BadgePiratesLLC/CactusCon_11/Images/20221024_151729.jpg

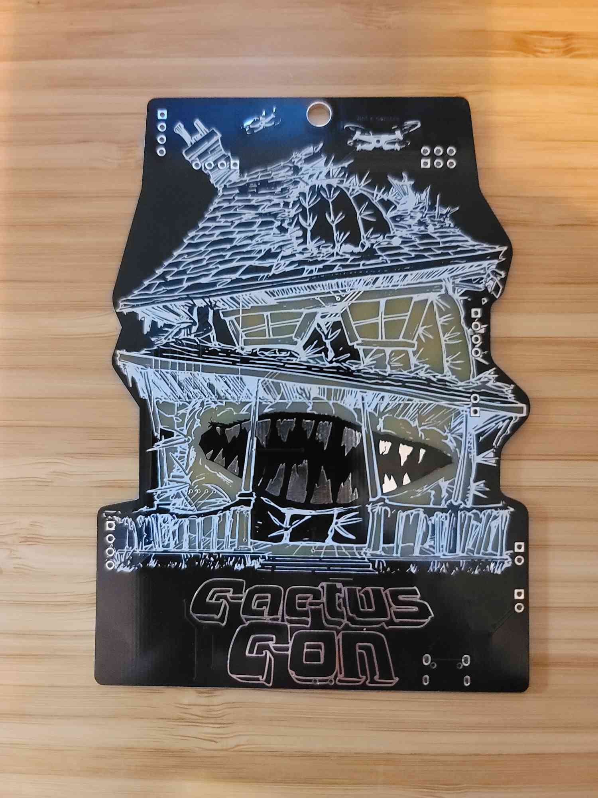
Images/20221024_151729.jpg
