BadgePiratesLLC/CactusCon_11/Images/Project-Saguaro_ Front.png

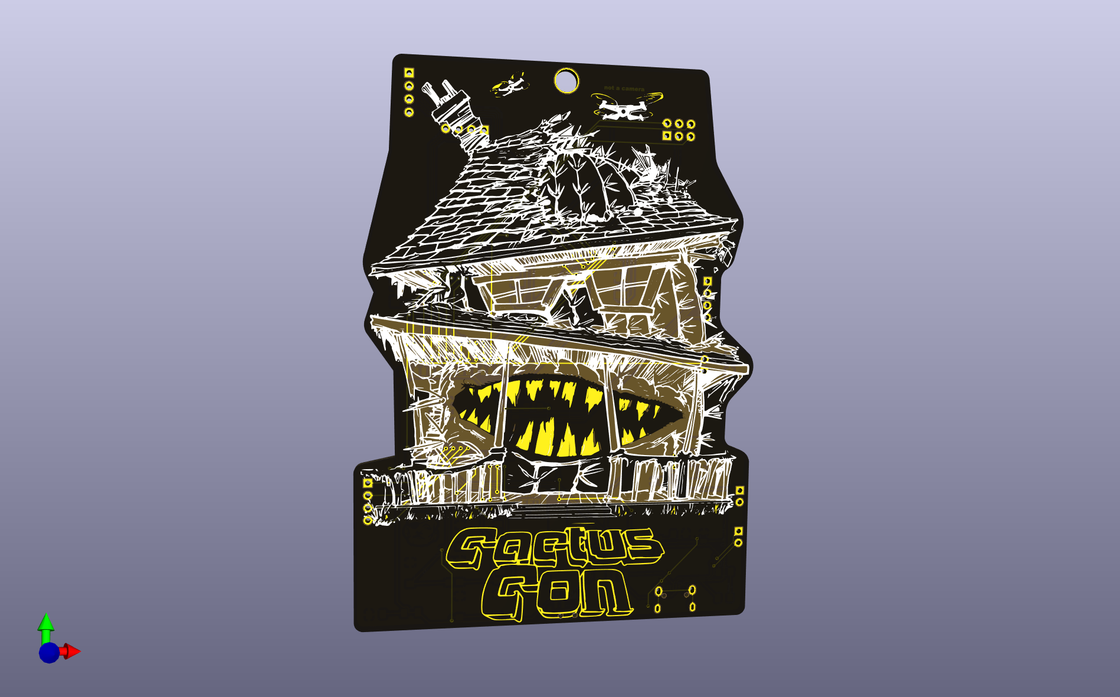
Images/Project-Saguaro_ Front.png
