BadgePiratesLLC/CactusCon_11/Code/oobe/include/badgepirates/README.md

# BadgePirates Common Code

Changes required in common header files:

* `factory.hpp` - Set up all LEDS to test, set factory mode behavior, and add includes for user code
