BadgePiratesLLC/CactusCon_11/CAD/CC11_Main.png

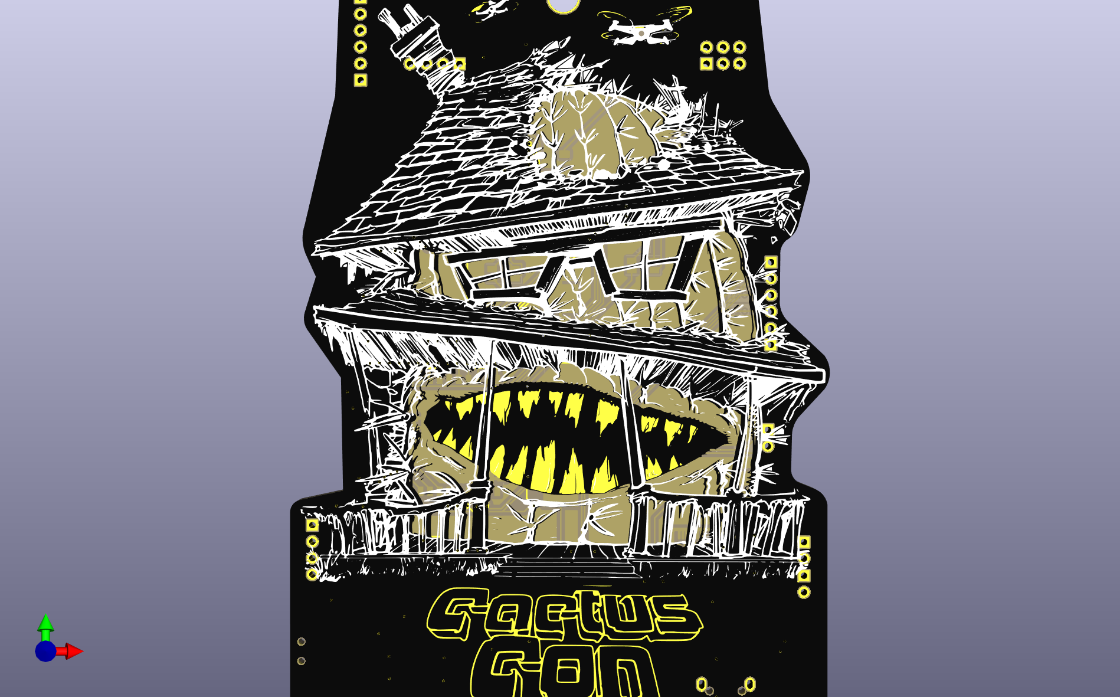
CAD/CC11_Main.png
