BadgePiratesLLC/CactusCon_11/Images/Project-Saguaro_ Back.png

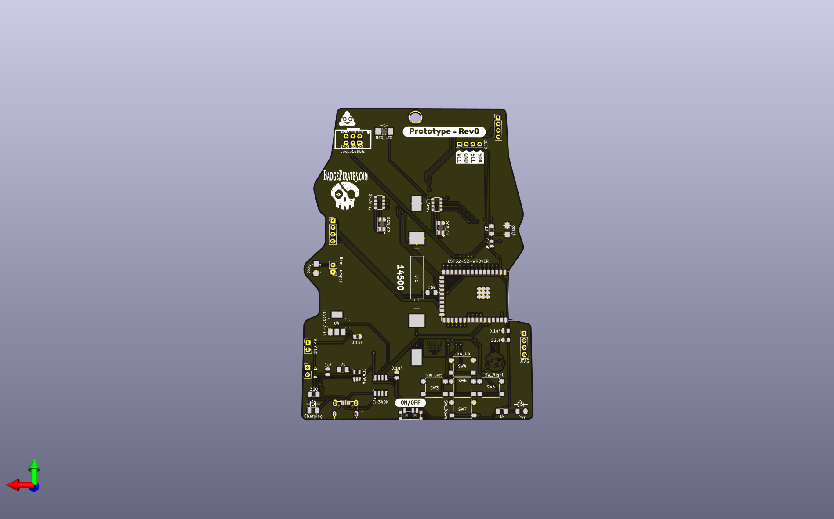
Images/Project-Saguaro_ Back.png
