BadgePiratesLLC/CactusCon_11/Documents/Schematics.pdf

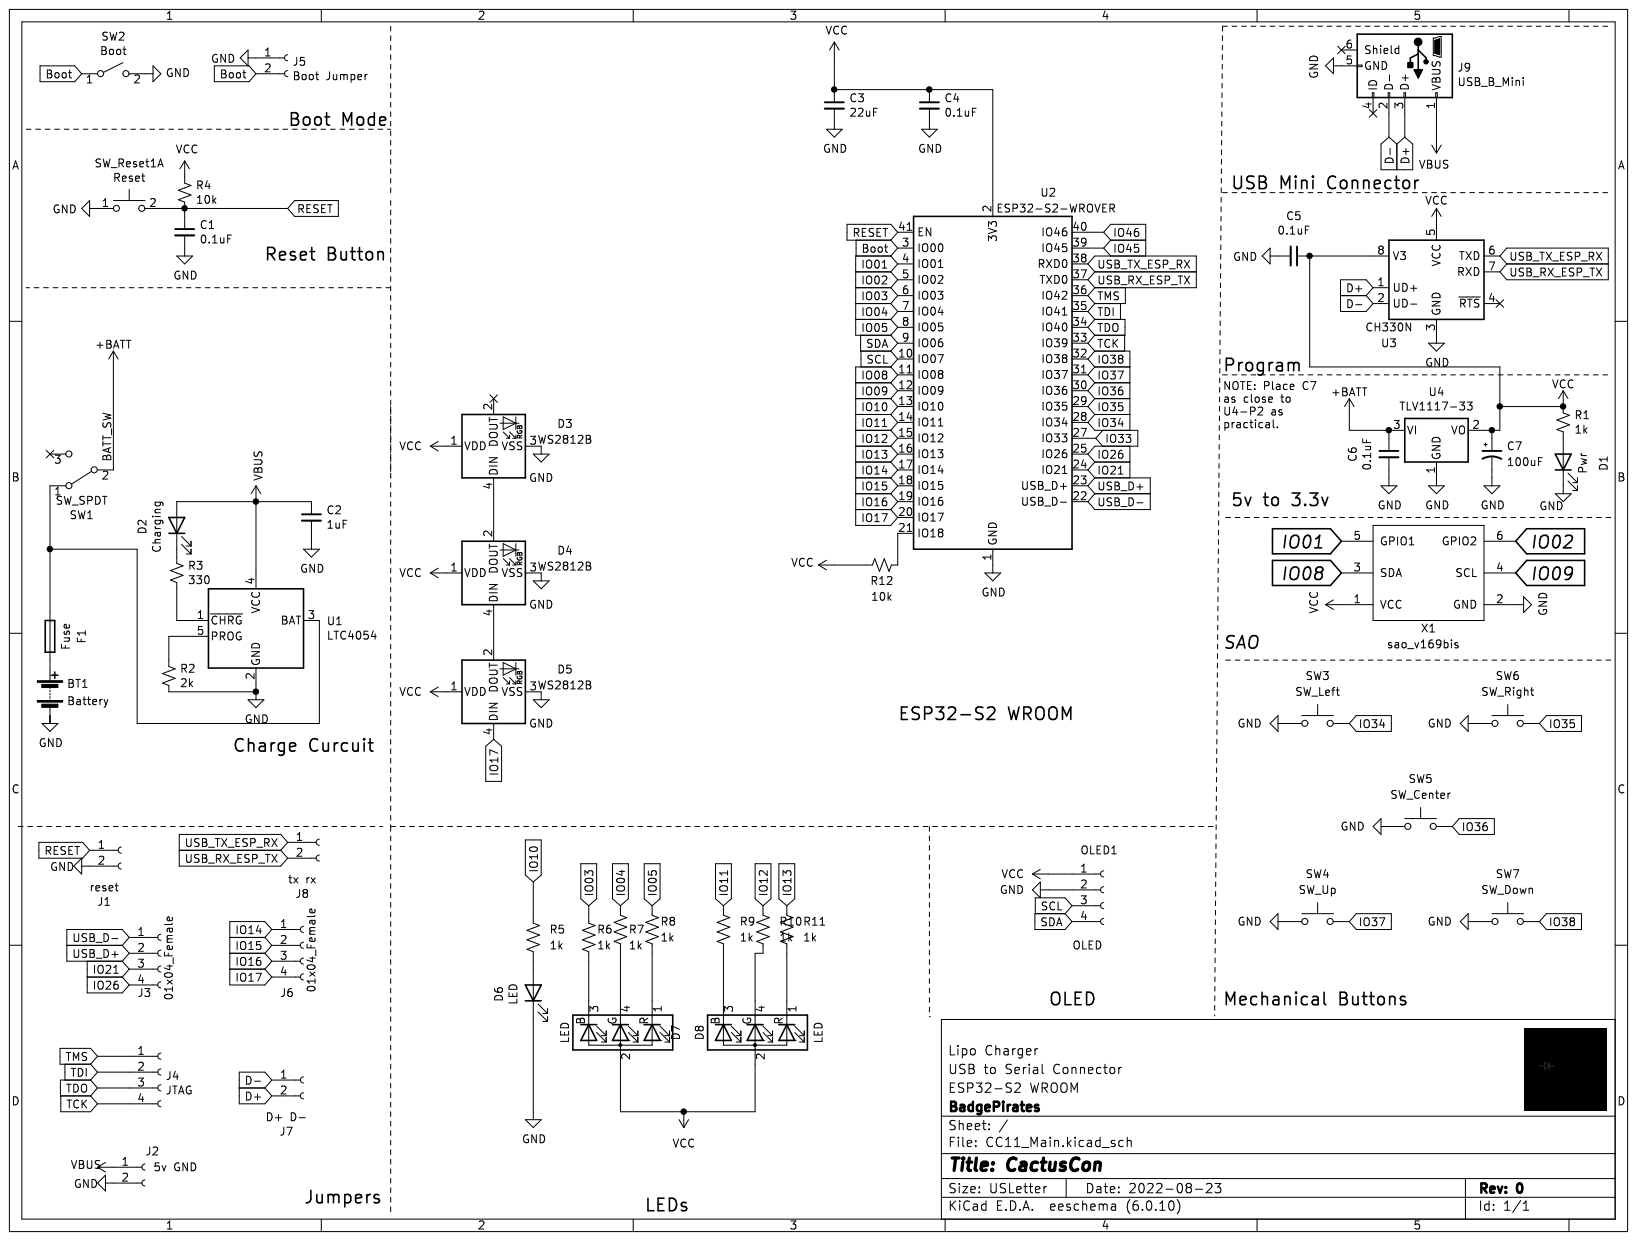
[picture p5: page 1]
