BadgePiratesLLC/CactusCon_11/CAD/CC11_Main.kicad_sch

## KiCad design CAD/CC11_Main.kicad_sch (2023-02-01)

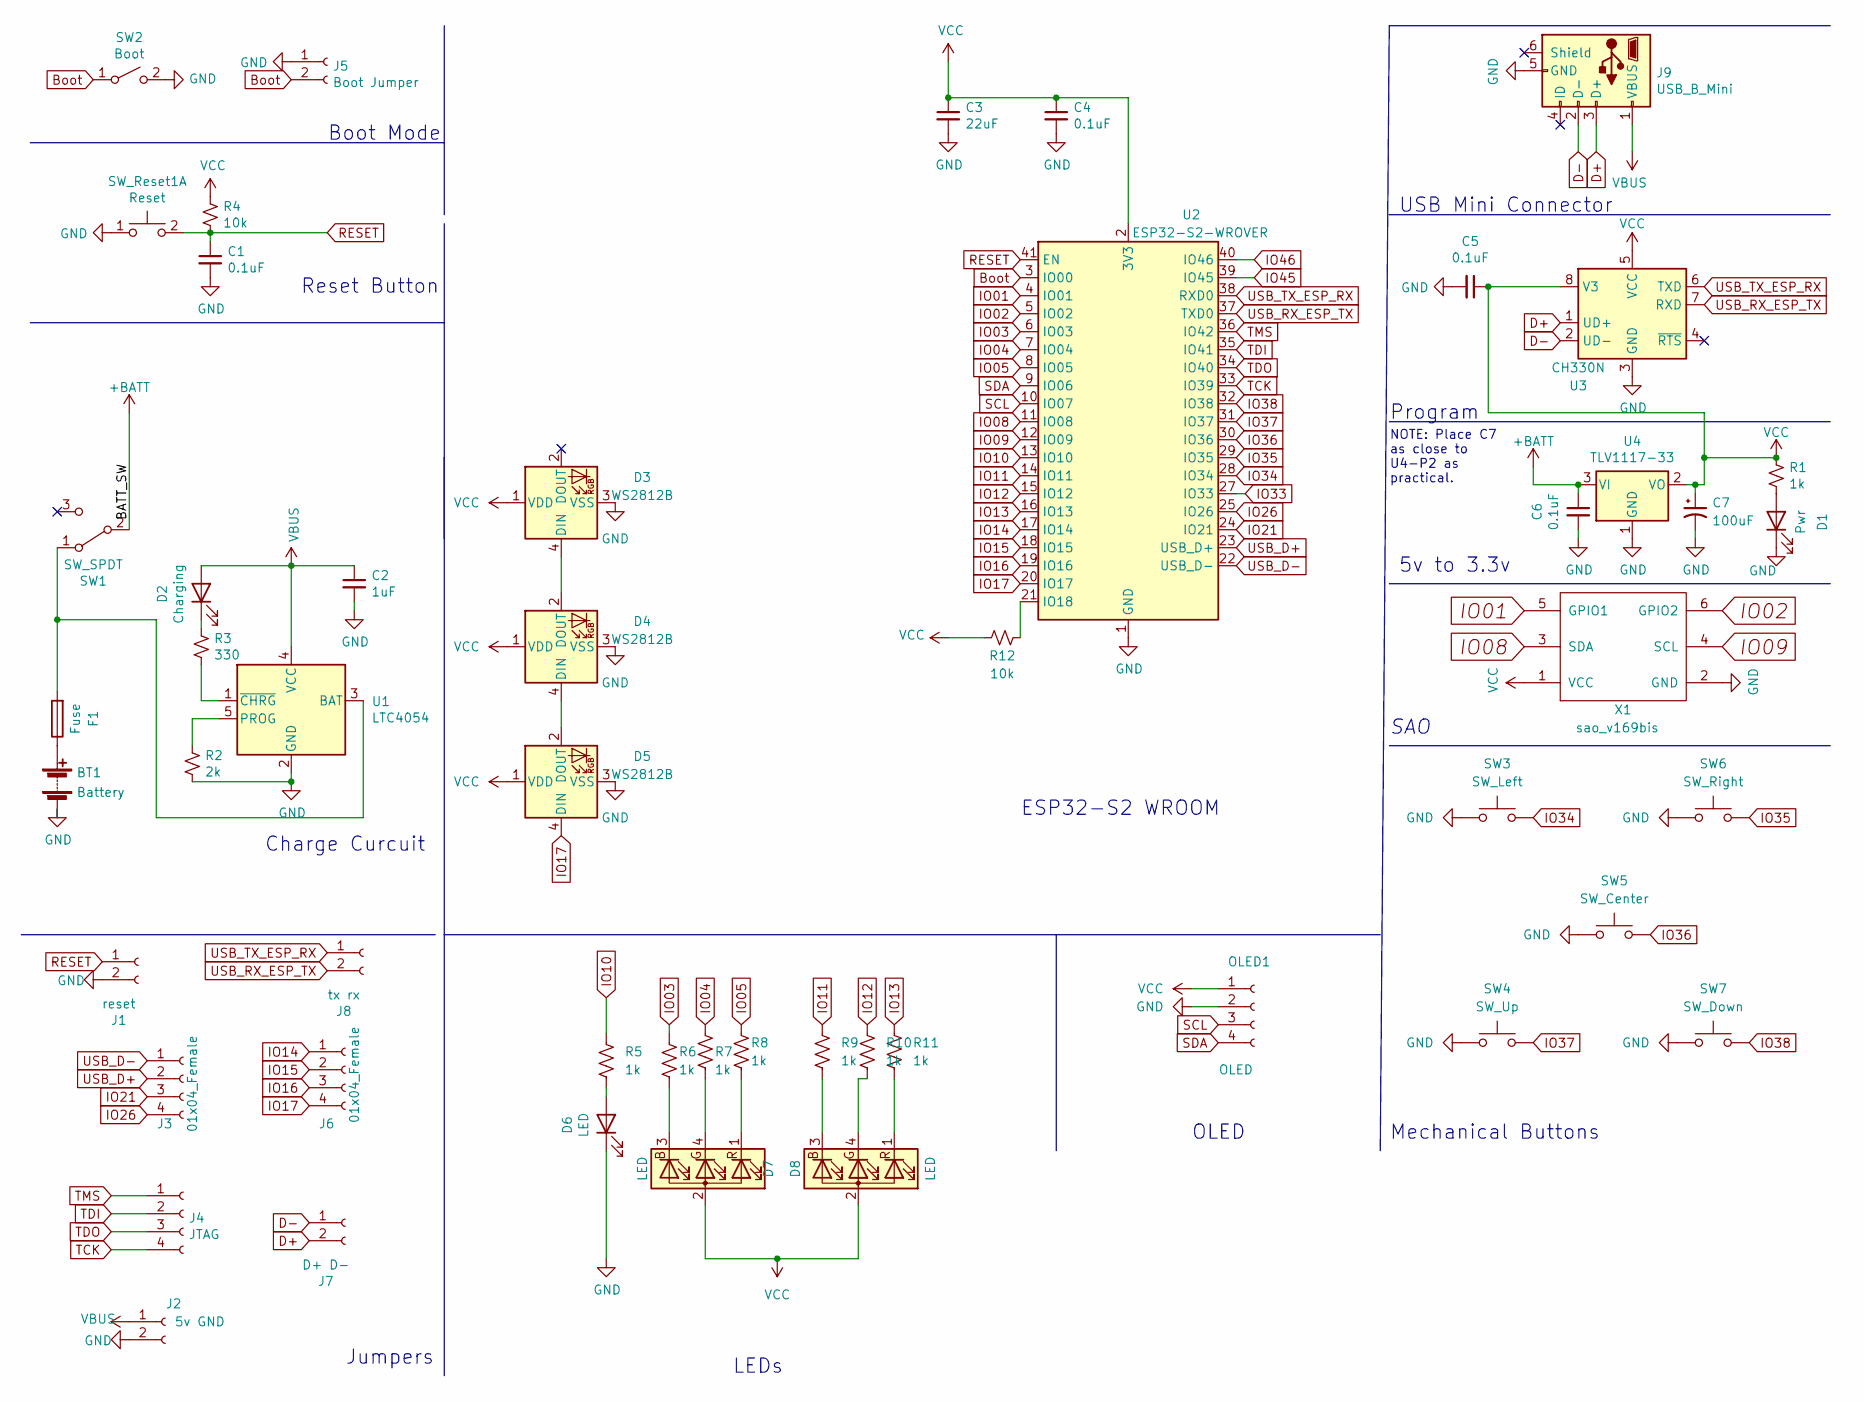
[picture p6: schematic CC11_Main.kicad_sch]

Parts:
BT1: Battery; Battery - 14500
C1, C4, C5, C6: 0.1uF; C_0805_2012Metric
C2: 1uF; C_0805_2012Metric
C3: 22uF; C_0805_2012Metric
C7: 100uF; CP_EIA-3528-21_Kemet-B_Pad1.50x2.35mm_HandSolder; MFG PN TAJB107M006RNJ
D1: Pwr; R_1206_3216Metric
D2: Charging; LED_1206_3216Metric
D3, D4, D5: WS2812B; LED_WS2812B_PLCC4_5.0x5.0mm_P3.2mm
D6: LED; LED_Osram_Lx_P47F_D2mm_ReverseMount_Proper_Mask Only
D7, D8: LED; LED_RGB_1210
F1: Fuse; R_1206_3216Metric
J1: reset; PinHeader_1x02_P2.54mm_Vertical
J2: 5v GND; PinHeader_1x02_P2.54mm_Vertical
J3, J6: 01x04_Female; PinHeader_1x04_P2.54mm_Vertical
J4: JTAG; PinHeader_1x04_P2.54mm_Vertical
J5: Boot Jumper; PinHeader_1x02_P2.54mm_Vertical
J7: D+ D-; PinHeader_1x02_P2.54mm_Vertical
J8: tx rx; PinHeader_1x02_P2.54mm_Vertical
J9: USB_B_Mini; USB_Micro-B_Wuerth
OLED1: OLED; PinHeader_1x04_P2.54mm_Vertical
R1, R5, R6, R7, R8, R9, R10, R11: 1k; R_1206_3216Metric
R2: 2k; R_1206_3216Metric
R3: 330; R_1206_3216Metric
R4, R12: 10k; R_1206_3216Metric
SW1: SW_SPDT; SW_SPDT_PCM12
SW2: Boot; Switch_Tactile_SMD_B3U-1000P-BPVersion
SW3: SW_Left; SW_SPST_B3S-1000
SW4: SW_Up; SW_SPST_B3S-1000
SW5: SW_Center; SW_SPST_B3S-1000
SW6: SW_Right; SW_SPST_B3S-1000
SW7: SW_Down; SW_SPST_B3S-1000
SW_Reset1: Reset; Switch_Tactile_SMD_B3U-1000P-BPVersion
U1: LTC4054
U2: ESP32-S2-WROVER; ESP32-S2-WROOM
U3: CH330N; SOIC-8-1EP_W3.9mm
U4: TLV1117-33; SOT-223_2-4_Combined
X1: sao_v169bis; Badgelife-SAOv169-SAO_Side_B.SLK

Connections:
+BATT: C6.1, SW1.2 (B), U4.3 (VI)
Boot: J5.2, SW2.1 (A), U2.3 (IO00)
D+: J7.2, J9.3 (D+), U3.1 (UD+)
D-: J7.1, J9.2 (D-), U3.2 (UD-)
GND: BT1.2 (-), C1.2, C2.2, C3.2, C4.2, C5.2, C6.2, C7.2, D1.1 (K), D3.3 (VSS), D4.3 (VSS), D5.3 (VSS), D6.1 (K), J1.2, J2.2, J5.1, J9.5 (GND), OLED1.2, R2.2, SW2.2 (B), SW3.1, SW4.1, SW5.1, SW6.1, SW7.1, SW_Reset1.1 (C), U1.2 (GND), U2.1 (GND), U2.26 (GND), U2.42 (GND), U2.43 (GND), U3.3 (GND), U4.1 (GND), X1.2 (GND)
IO01: U2.4 (IO01), X1.5 (GPIO1)
IO02: U2.5 (IO02), X1.6 (GPIO2)
IO03: R6.1, U2.6 (IO03)
IO04: R7.1, U2.7 (IO04)
IO05: R8.1, U2.8 (IO05)
IO08: U2.11 (IO08), X1.3 (SDA)
IO09: U2.12 (IO09), X1.4 (SCL)
IO10: R5.1, U2.13 (IO10)
IO11: R9.1, U2.14 (IO11)
IO12: R10.1, U2.15 (IO12)
IO13: R11.1, U2.16 (IO13)
IO14: J6.1, U2.17 (IO14)
IO15: J6.2, U2.18 (IO15)
IO16: J6.3, U2.19 (IO16)
IO17: D5.4 (DIN), J6.4, U2.20 (IO17)
IO21: J3.3, U2.24 (IO21)
IO26: J3.4, U2.25 (IO26)
IO33: U2.27 (IO33)
IO34: SW3.2, U2.28 (IO34)
IO35: SW6.2, U2.29 (IO35)
IO36: SW5.2, U2.30 (IO36)
IO37: SW4.2, U2.31 (IO37)
IO38: SW7.2, U2.32 (IO38)
IO45: U2.39 (IO45)
IO46: U2.40 (IO46)
unnamed: BT1.1 (+), F1.1
unnamed: D1.2 (A), R1.2
unnamed: D2.1 (K), R3.1
unnamed: D3.4 (DIN), D4.2 (DOUT)
unnamed: D4.4 (DIN), D5.2 (DOUT)
unnamed: D6.2 (A), R5.2
unnamed: D7.1 (RK), R8.2
unnamed: D7.3 (BK), R6.2
unnamed: D7.4 (GK), R7.2
unnamed: D8.1 (RK), R11.2
unnamed: D8.3 (BK), R9.2
unnamed: D8.4 (GK), R10.2
unnamed: F1.2, SW1.1 (A), U1.3 (BAT)
unnamed: R2.1, U1.5 (PROG)
unnamed: R3.2, U1.1 (~CHRG)
unnamed: R12.1, U2.21 (IO18)
RESET: C1.1, J1.1, R4.2, SW_Reset1.2 (D), U2.41 (EN)
SCL: OLED1.3, U2.10 (IO07)
SDA: OLED1.4, U2.9 (IO06)
TCK: J4.4, U2.33 (IO39)
TDI: J4.2, U2.35 (IO41)
TDO: J4.3, U2.34 (IO40)
TMS: J4.1, U2.36 (IO42)
USB_D+: J3.2, U2.23 (USB_D+)
USB_D-: J3.1, U2.22 (USB_D-)
USB_RX_ESP_TX: J8.2, U2.37 (TXD0), U3.7 (RXD)
USB_TX_ESP_RX: J8.1, U2.38 (RXD0), U3.6 (TXD)
VBUS: C2.1, D2.2 (A), J2.1, J9.1 (VBUS), U1.4 (VCC)
VCC: C3.1, C4.1, C5.1, C7.1, D3.1 (VDD), D4.1 (VDD), D5.1 (VDD), D7.2 (A), D8.2 (A), OLED1.1, R1.1, R4.1, R12.2, U2.2 (3V3), U3.5 (VCC), U3.8 (V3), U4.2 (VO), X1.1 (VCC)

Notes on the sheet:
SAO
NOTE: Place C7 as close to U4-P2 as practical.
Charge Curcuit
Mechanical Buttons
USB Mini Connector
Jumpers
ESP32-S2 WROOM
OLED
5v to 3.3v
Program
Boot Mode
Reset Button
LEDs
